aleksandrosip2008-netizen/-/Смета.xlsx

Деталь | Модель | Габарит | Кол-во | Цена | Стоимость
Двигатель | 25GA-370-100 | D25x54 | 6 | 320 | 1920
Драйвер дв. | L298N | 44 x 44 x 28 мм | 1 | 134 | 134
Ступица |  | D12x20 | 2 | 154 | 308
Колеса |  |  | 2 | 496 | 992
GPS | ATGM336H |  |  |  | 0
 | GY-NEO7M | 40x30 | 0 | 600 | 0
Компас | GY-273 | 20x15 | 1 | 278 | 278
Ультразвук | HC-SR04 |  | 1 | 200 | 200
УНЧ | PAM8403 | 30x15 | 1 | 140 | 140
MP3 | MP3 Mini | 25x20 | 1 | 300 | 300
Solar | CN3767/CN3722 | 50x30 | 0 | 230 | 0
Solar панель | 5V120MA | 100х60 | 0 | 104 | 0
GSM | SIM800L | 40x30 | 0 | 600 | 0
MICRO SD | MICRO SD | 40x30 | 0 | 200 | 0
ESP | ESP8266 | 60x30 | 0 | 300 | 0
Панель |  | 400х300 | 1 | 315 | 315
Батар. Бл. |  | 80х80 | 1 | 127 | 127
Стаб. Пит. | MP1584EN | 25ч20 | 1 | 130 | 130
Гиро | GY-521 |  | 0 |  | 0
Давление | GY-68 |  | 0 |  | 0
ESP32 | ESP32 |  | 1 | 470 | 470
Серво | 28BYJ-48 |  | 1 | 100 | 100
Др. серво | ULN2003 |  | 1 | 180 | 180
 |  |  |  |  | 5594
